SD-RTMS/flight-unit/README.md

# flight-unit


flight unit hardware and software
