SD-RTMS/flight-unit/(threads)

Thread 4 (2020-11-05):

Re-program Issue

danielstumpp, 2020-11-05:
For some reason once the board is programmed once it needs to be manually reprogrammed before flashing new code to the board.

My best guess is that this is caused by dynamic memory allocation somewhere.

This isn't preventing development, but it is pretty annoying.

danielstumpp, 2020-11-05:
Update: it is definitely an issue in either fram.cpp, memory_if.cpp, or downlink_messages.cpp. I think it is in downlink_messages

danielstumpp, 2020-11-05:
looks like I have a fix for this. I will submit a PR and outline it there

Closed 2020-11-06.

Thread 5 (2020-11-05):

FRAM Lib Dependencies

danielstumpp, 2020-11-05:
There is an issue with FRAM SPI library dependencies which is causing CI builds to fail. It's on my to-do list but not high up there
