SD-RTMS/flight-unit/hardware/flight_unit.brd

## EAGLE design hardware/flight_unit.brd (2020-09-25)

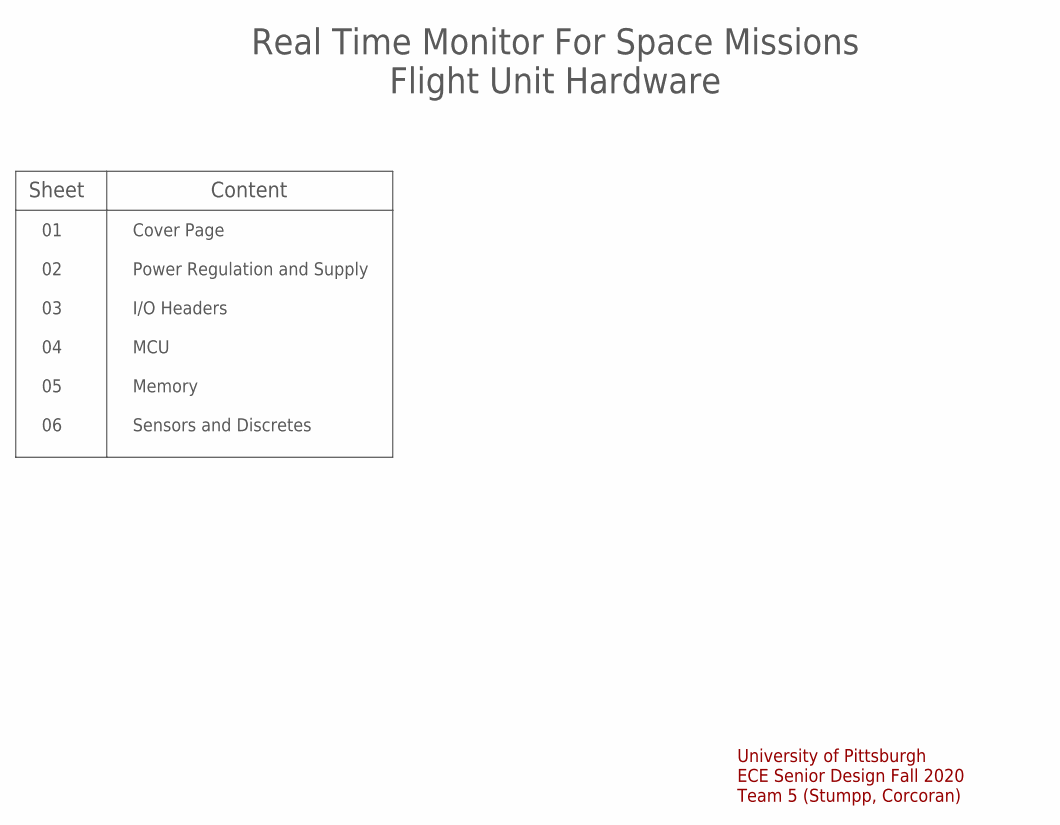
[picture p7: schematic flight_unit.sch, sheet 1]

Notes on the sheet:
University of Pittsburgh ECE Senior Design Fall 2020 Team 5 (Stumpp, Corcoran)
Real Time Monitor For Space Missions Flight Unit Hardware
Content
01 02 03 04 05 06
Cover Page Power Regulation and Supply I/O Headers MCU Memory Sensors and Discretes
Sheet

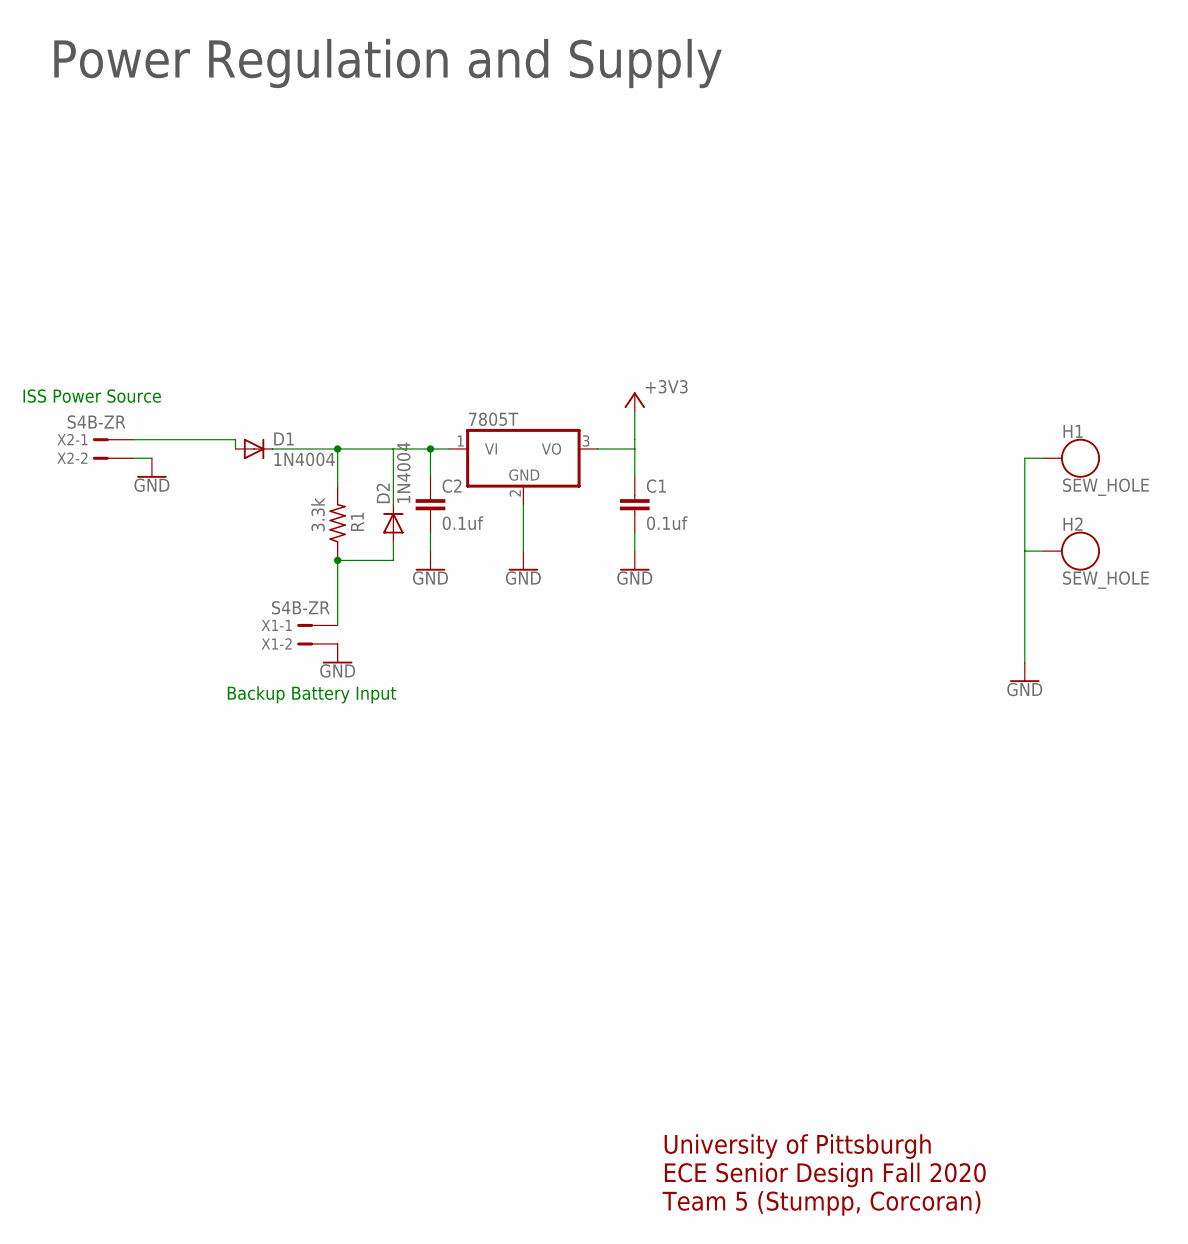
[picture p8: schematic flight_unit.sch, sheet 2]

Parts:
C1, C2: 0.1uf; C2.5-3
D1, D2: 1N4004; DO41-10
H1, H2: SEW_HOLE; SIMPLE_HOLE
IC2: 7805T; TO220H
R1: 3.3k; 0207/10
X1, X2: S4B-ZR

Connections:
+3V3: C1.1, IC2.3 (VO); also elsewhere on the board
GND: C1.2, C2.2, H1.P$1, H2.P$1, IC2.2 (GND), X1.2, X2.2; also elsewhere on the board
unnamed: D2.A, R1.1, X1.1
unnamed: C2.1, D1.C, D2.C, IC2.1 (VI), R1.2
unnamed: D1.A, X2.1

Notes on the sheet:
University of Pittsburgh ECE Senior Design Fall 2020 Team 5 (Stumpp, Corcoran)
Power Regulation and Supply
ISS Power Source
Backup Battery Input

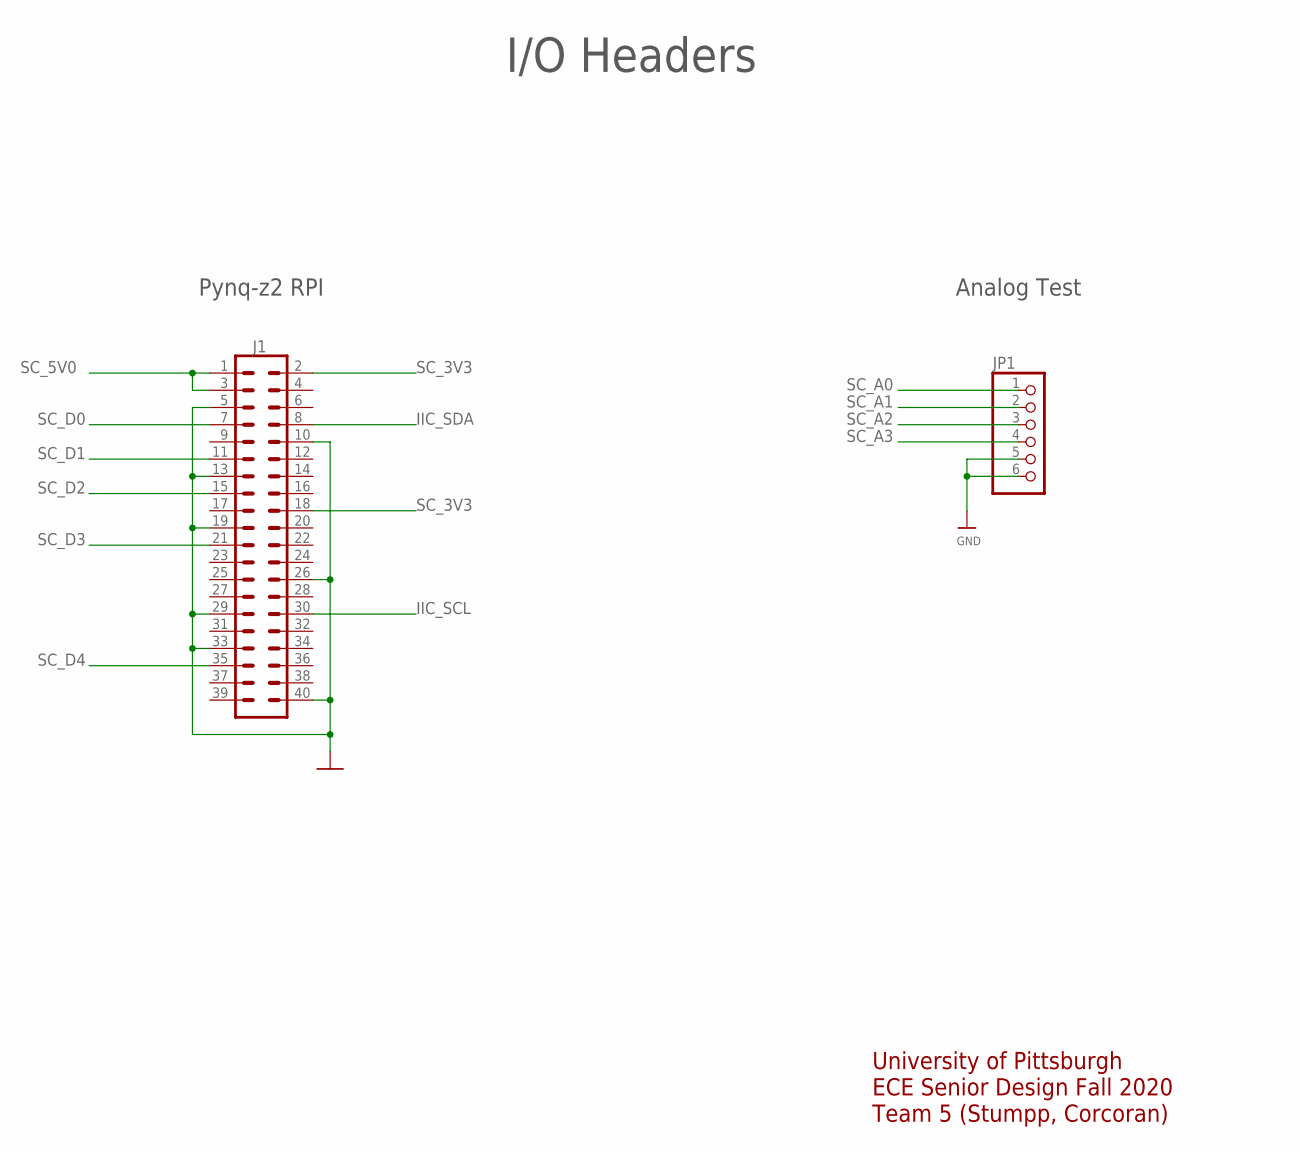
[picture p9: schematic flight_unit.sch, sheet 3]

Parts:
J1: CONN_20X2SHROUDED; 2X20_SHROUDED
JP1: PINHD-1X6B; 1X06-BIG

Connections:
GND: J1.5, J1.10, J1.13, J1.19, J1.26, J1.29, J1.33, J1.40, JP1.5, JP1.6; also elsewhere on the board
IIC_SCL: J1.30; also elsewhere on the board
IIC_SDA: J1.8; also elsewhere on the board
SC_3V3: J1.2, J1.18; also elsewhere on the board
SC_5V0: J1.1, J1.3; also elsewhere on the board
SC_A0: JP1.1; also elsewhere on the board
SC_A1: JP1.2; also elsewhere on the board
SC_A2: JP1.3; also elsewhere on the board
SC_A3: JP1.4; also elsewhere on the board
SC_D0: J1.7; also elsewhere on the board
SC_D1: J1.11; also elsewhere on the board
SC_D2: J1.15; also elsewhere on the board
SC_D3: J1.21; also elsewhere on the board
SC_D4: J1.35; also elsewhere on the board

Notes on the sheet:
University of Pittsburgh ECE Senior Design Fall 2020 Team 5 (Stumpp, Corcoran)
I/O Headers
Analog Test
Pynq-z2 RPI

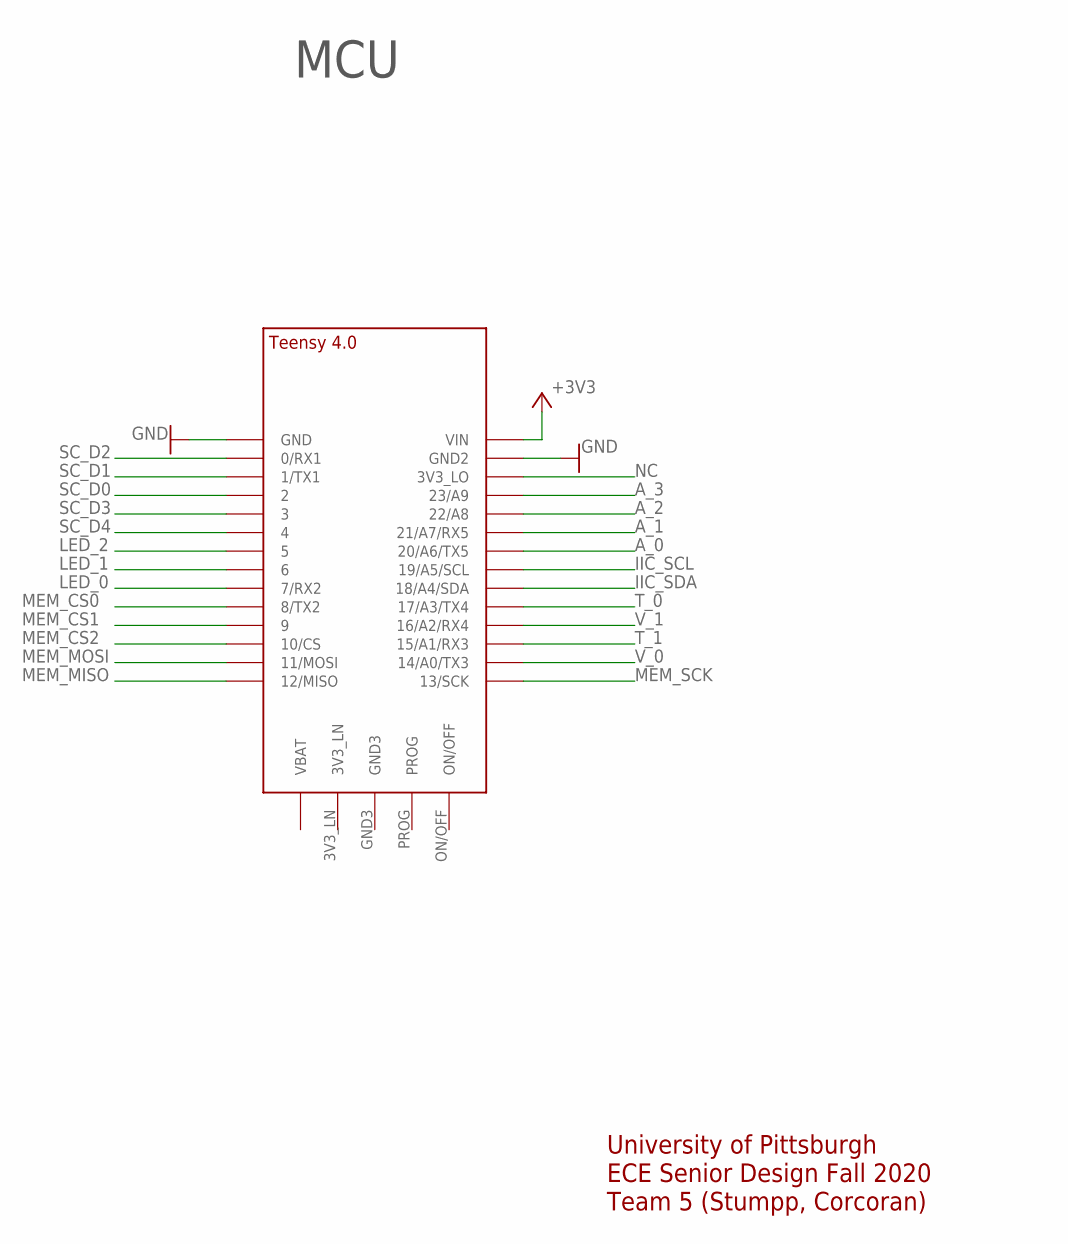
[picture p10: schematic flight_unit.sch, sheet 4]

Parts:
U$1: TEENSY_4.0

Connections:
+3V3: U$1.VIN; also elsewhere on the board
A_0: U$1.20/A6 (20/A6/TX5); also elsewhere on the board
A_1: U$1.21/A7 (21/A7/RX5); also elsewhere on the board
A_2: U$1.22/A8; also elsewhere on the board
A_3: U$1.23/A9; also elsewhere on the board
GND: U$1.GND, U$1.GND2; also elsewhere on the board
IIC_SCL: U$1.19/A5/SCL; also elsewhere on the board
IIC_SDA: U$1.18/A4/SDA; also elsewhere on the board
LED_0: U$1.7 (7/RX2); also elsewhere on the board
LED_1: U$1.6; also elsewhere on the board
LED_2: U$1.5; also elsewhere on the board
MEM_CS0: U$1.8 (8/TX2); also elsewhere on the board
MEM_CS1: U$1.9/CS (9); also elsewhere on the board
MEM_CS2: U$1.10/CS; also elsewhere on the board
MEM_MISO: U$1.12/MISO; also elsewhere on the board
MEM_MOSI: U$1.11/MOSI; also elsewhere on the board
MEM_SCK: U$1.13/SCK; also elsewhere on the board
NC: U$1.3V3_LO
SC_D0: U$1.2; also elsewhere on the board
SC_D1: U$1.1/TX (1/TX1); also elsewhere on the board
SC_D2: U$1.0/RX (0/RX1); also elsewhere on the board
SC_D3: U$1.3/CANTX (3); also elsewhere on the board
SC_D4: U$1.4/CANRX (4); also elsewhere on the board
T_0: U$1.17/A3 (17/A3/TX4); also elsewhere on the board
T_1: U$1.15/A1 (15/A1/RX3); also elsewhere on the board
V_0: U$1.14/A0 (14/A0/TX3); also elsewhere on the board
V_1: U$1.16/A2 (16/A2/RX4); also elsewhere on the board

Notes on the sheet:
University of Pittsburgh ECE Senior Design Fall 2020 Team 5 (Stumpp, Corcoran)
MCU

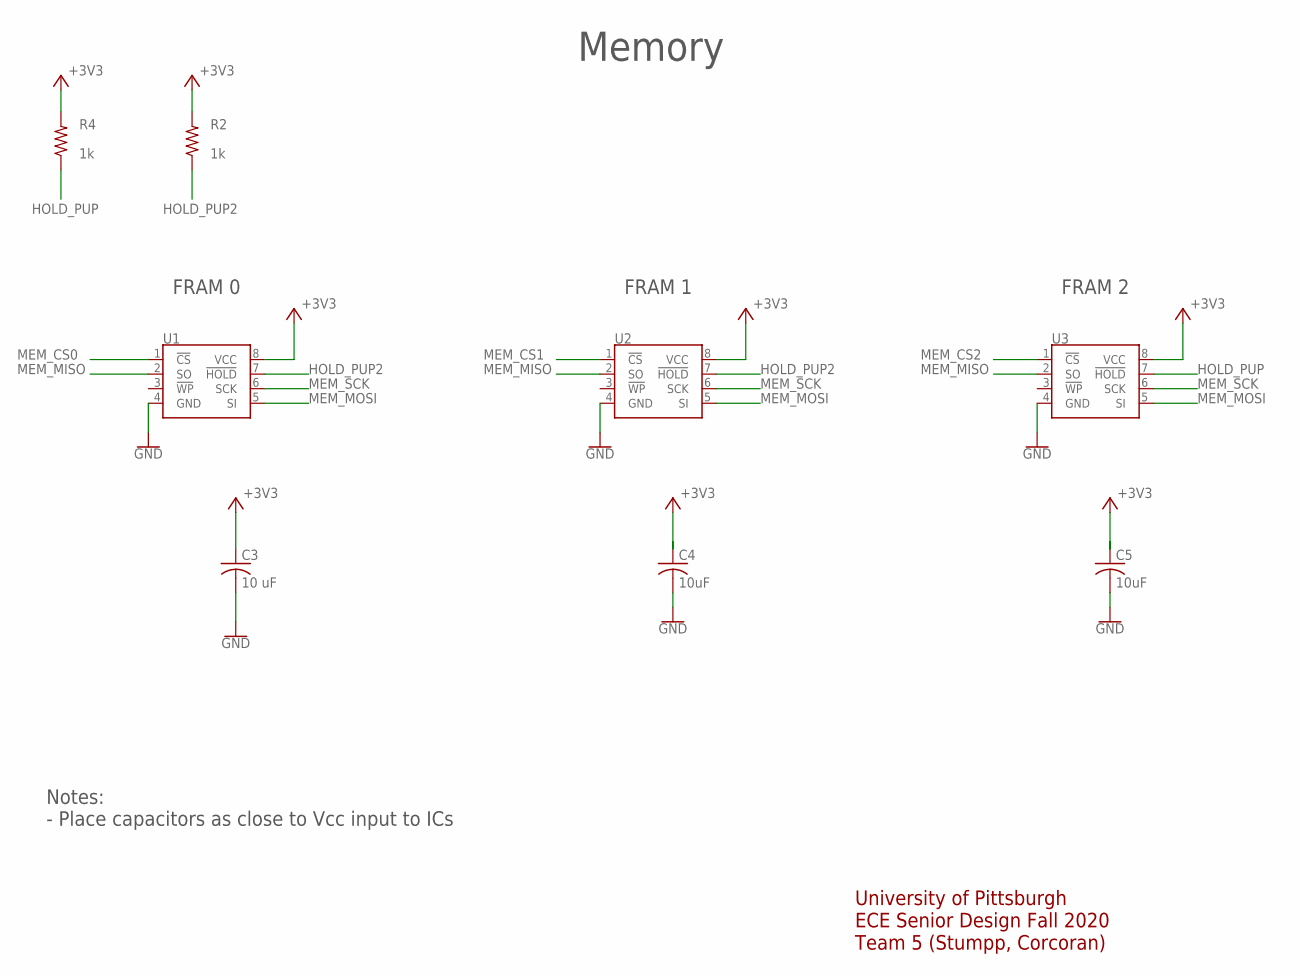
[picture p11: schematic flight_unit.sch, sheet 5]

Parts:
C3: 10 uF; C0805K
C4, C5: 10uF; C0805K
R2, R4: 1k; R1210
U1, U2, U3: 4MB Flash; SO08

Connections:
+3V3: C3.1, C4.1, C5.1, R2.2, R4.2, U1.8 (VCC), U2.8 (VCC), U3.8 (VCC); also elsewhere on the board
GND: C3.2, C4.2, C5.2, U1.4 (GND), U2.4 (GND), U3.4 (GND); also elsewhere on the board
HOLD_PUP: R4.1, U3.7 (!HOLD)
HOLD_PUP2: R2.1, U1.7 (!HOLD), U2.7 (!HOLD)
MEM_CS0: U1.1 (!CS); also elsewhere on the board
MEM_CS1: U2.1 (!CS); also elsewhere on the board
MEM_CS2: U3.1 (!CS); also elsewhere on the board
MEM_MISO: U1.2 (SO), U2.2 (SO), U3.2 (SO); also elsewhere on the board
MEM_MOSI: U1.5 (SI), U2.5 (SI), U3.5 (SI); also elsewhere on the board
MEM_SCK: U1.6 (SCK), U2.6 (SCK), U3.6 (SCK); also elsewhere on the board

Notes on the sheet:
University of Pittsburgh ECE Senior Design Fall 2020 Team 5 (Stumpp, Corcoran)
Memory
FRAM 0
FRAM 1
FRAM 2
Notes: - Place capacitors as close to Vcc input to ICs

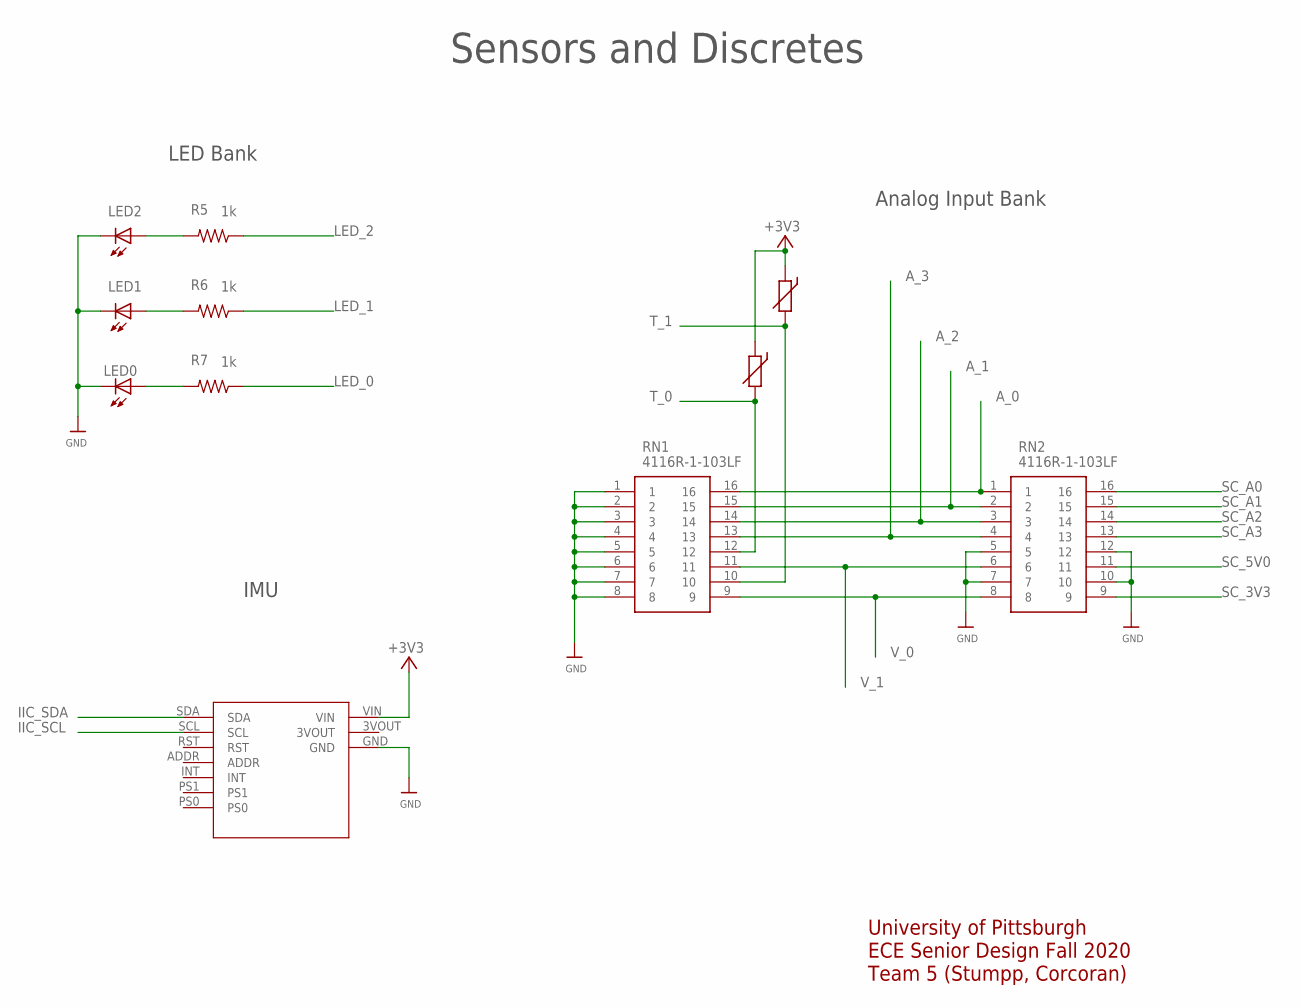
[picture p12: schematic flight_unit.sch, sheet 6]

Parts:
LED0, LED1, LED2: LED3MM
R5, R6, R7: 1k; R1210
R8: THERMISTOR-2,5; RS-2,5
RN1, RN2: 4116R-1-103LF; DIP787W49P254L2197H469Q16N
T1: THERMISTOR-2,5; RS-2,5
U$3: IMU_BREAKOUT; BNO055_BREAKOUT

Connections:
+3V3: R8.1, T1.1, U$3.VIN; also elsewhere on the board
A_0: RN1.16, RN2.1; also elsewhere on the board
A_1: RN1.15, RN2.2; also elsewhere on the board
A_2: RN1.14, RN2.3; also elsewhere on the board
A_3: RN1.13, RN2.4; also elsewhere on the board
GND: LED0.K (C), LED1.K (C), LED2.K (C), RN1.1, RN1.2, RN1.3, RN1.4, RN1.5, RN1.6, RN1.7, RN1.8, RN2.5, RN2.7, RN2.10, RN2.12, U$3.GND; also elsewhere on the board
IIC_SCL: U$3.SCL; also elsewhere on the board
IIC_SDA: U$3.SDA; also elsewhere on the board
LED_0: R7.1; also elsewhere on the board
LED_1: R6.1; also elsewhere on the board
LED_2: R5.1; also elsewhere on the board
unnamed: LED0.A, R7.2
unnamed: LED1.A, R6.2
unnamed: LED2.A, R5.2
SC_3V3: RN2.9; also elsewhere on the board
SC_5V0: RN2.11; also elsewhere on the board
SC_A0: RN2.16; also elsewhere on the board
SC_A1: RN2.15; also elsewhere on the board
SC_A2: RN2.14; also elsewhere on the board
SC_A3: RN2.13; also elsewhere on the board
T_0: R8.2, RN1.12; also elsewhere on the board
T_1: RN1.10, T1.2; also elsewhere on the board
V_0: RN1.9, RN2.8; also elsewhere on the board
V_1: RN1.11, RN2.6; also elsewhere on the board

Notes on the sheet:
University of Pittsburgh ECE Senior Design Fall 2020 Team 5 (Stumpp, Corcoran)
Sensors and Discretes
IMU
LED Bank
Analog Input Bank

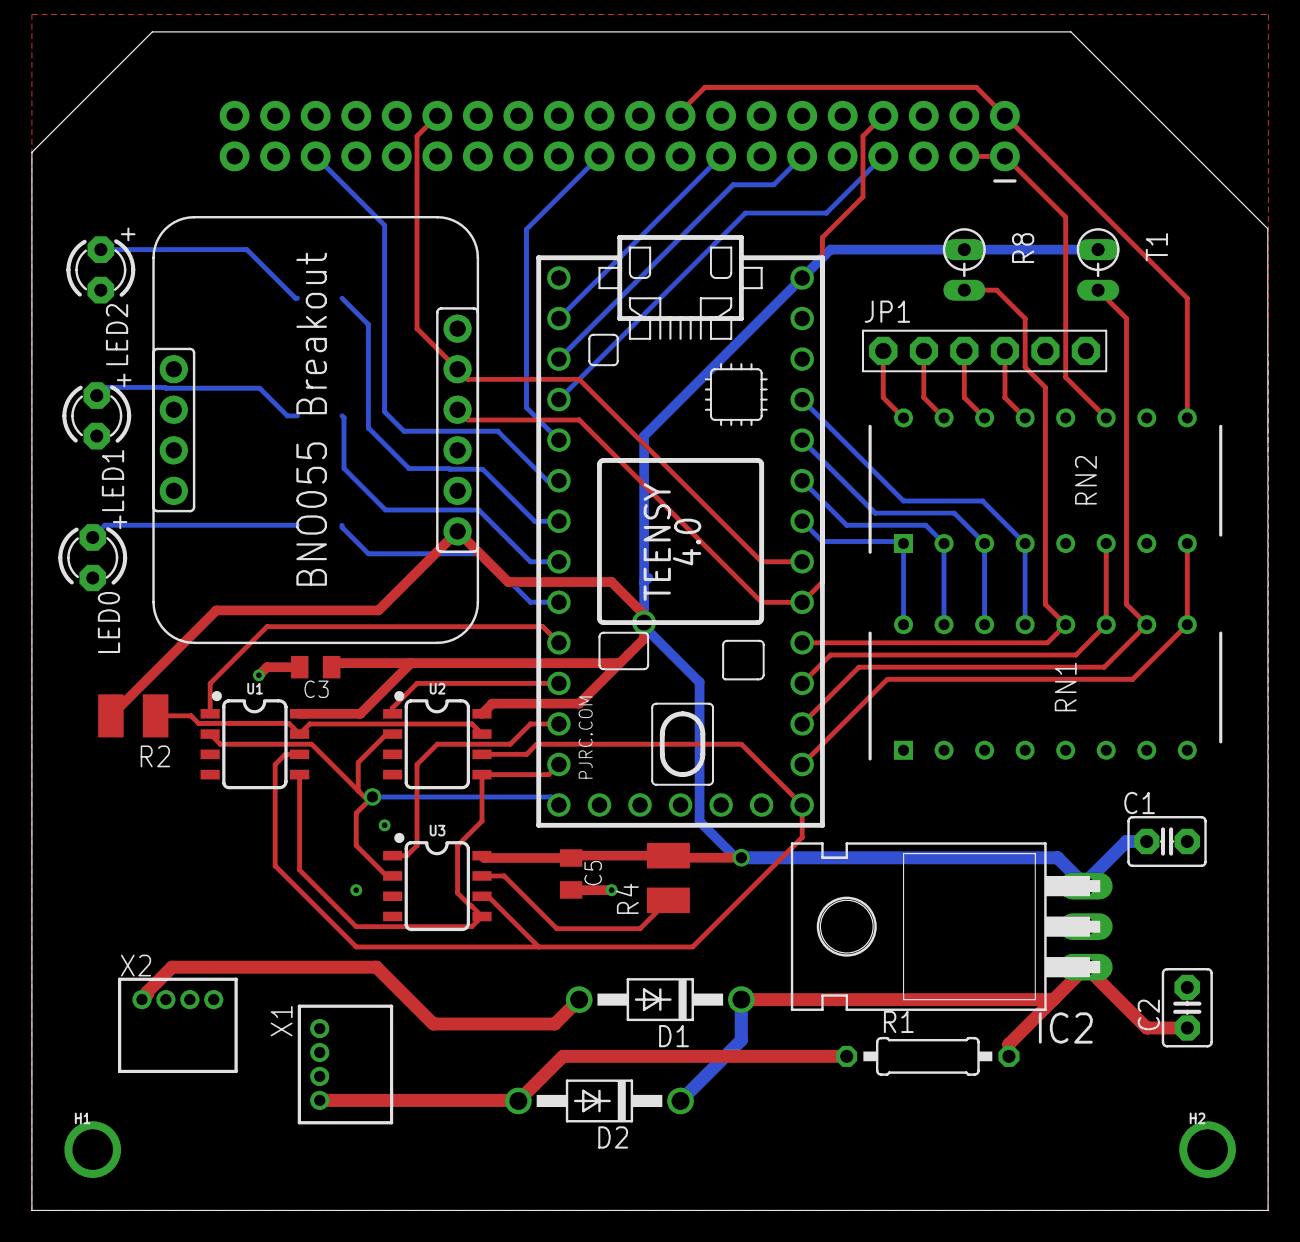
[picture p13: board flight_unit.brd from above]

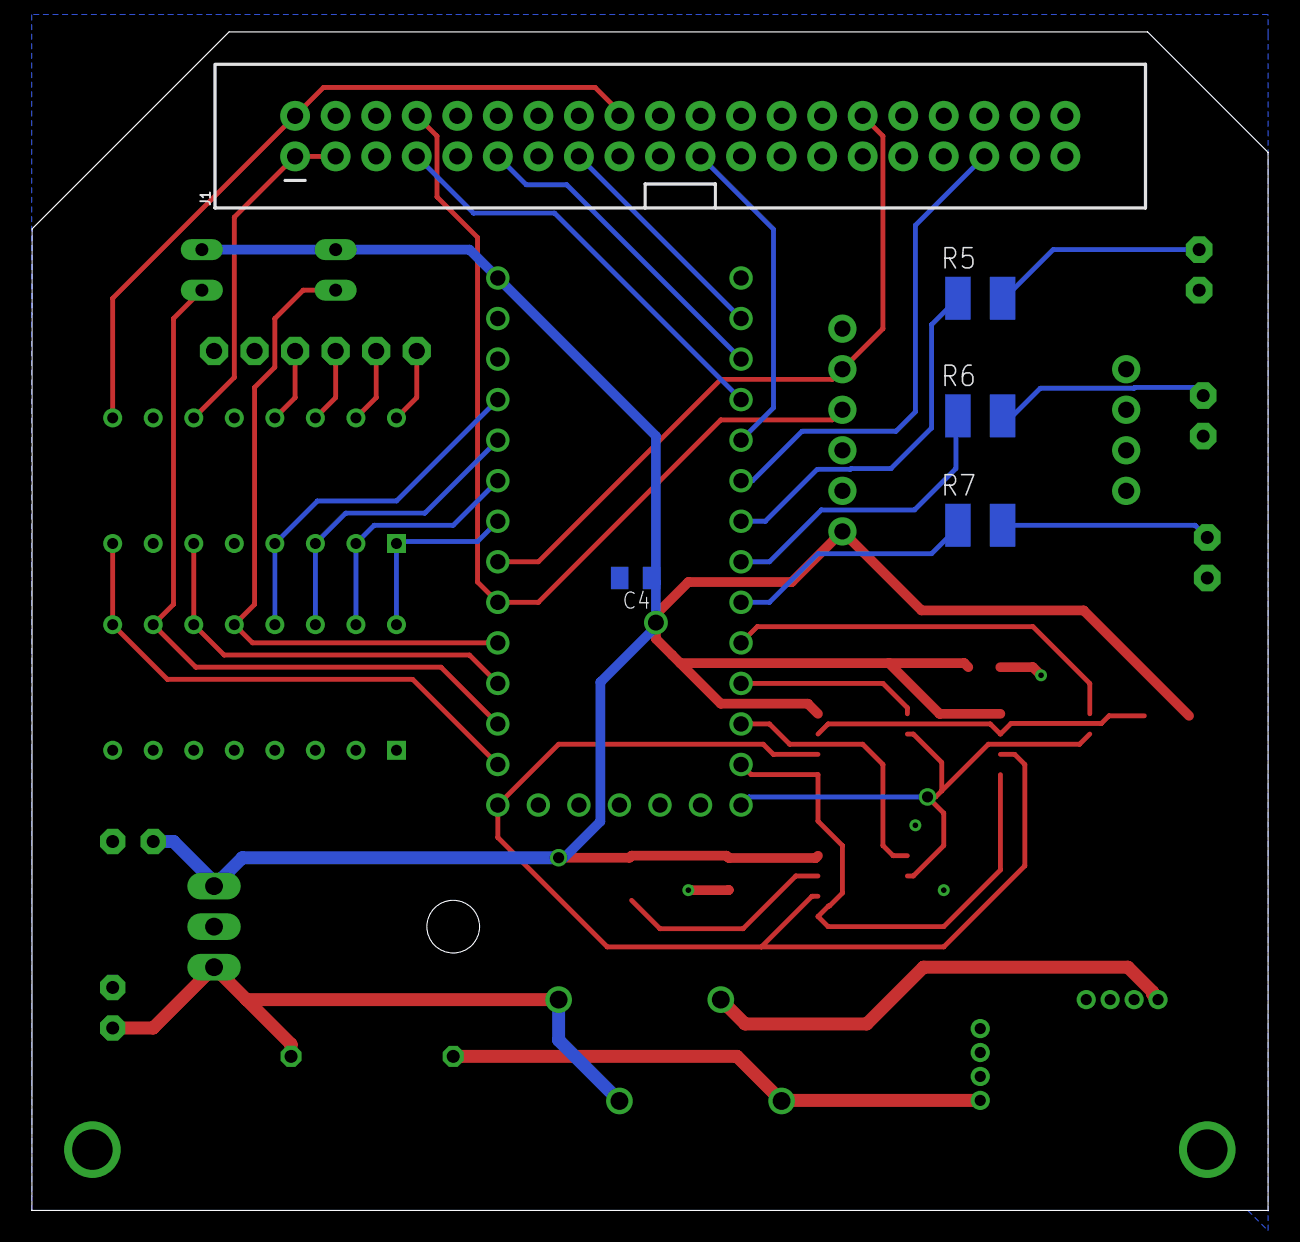
[picture p14: board flight_unit.brd from below]

Board: 2 copper layers, 77.5 x 73.8 mm, 32 parts (5 on the bottom side), 40 nets.
