SD-RTMS/flight-unit/(commit log)

2020-09-16 updated file structure
    [RTMS Voltage Regulation Circuit.sch]
2020-09-16 created master schematic
    [flight_unit.sch]
2020-09-17 finished teplate and added pynq-z2 connector
    [flight_unit.sch]
2020-09-17 added fram and MCU
    [flight_unit.sch]
2020-09-18 Added DIP resistor packages for analog bank
    [flight_unit.sch]
2020-09-18 Created and added IMU library part
    [flight_unit.brd, flight_unit.sch]
2020-09-18 updated i/o headers
    [flight_unit.brd, flight_unit.sch]
2020-09-18 created pin map header
2020-09-18 added digital_io class framework
2020-09-20 added start of fram framework
    [flight_unit.brd, flight_unit.sch]
2020-09-21 fix back annotation error
    [flight_unit.brd]
2020-09-21 fixed back annotation error **don't copy and replace the schematic**
    [flight_unit.brd, flight_unit.sch]
2020-09-21 added imu repo as submodule
2020-09-21 accidently deleted this
    [flight_unit.brd, flight_unit.sch]
2020-09-22 Added decoupling caps to memory schematic
    [flight_unit.brd, flight_unit.sch]
2020-09-22 updates to schematic and preliminary board work
    [flight_unit.brd, flight_unit.sch]
2020-09-22 working on board layout
    [flight_unit.brd, flight_unit.sch]
2020-09-24 working on routing...
    [flight_unit.brd, flight_unit.sch]
2020-09-24 few more tweaks.
    [flight_unit.brd, flight_unit.sch]
2020-09-25 finalized preliminary routing
    [flight_unit.brd, flight_unit.sch]
2020-10-21 Fixed case sensitive includes for linux build
    [imu.cpp, main.cpp]
2020-10-23 Thermistors
    Converts analog signal to thermistor temp readings
2020-11-03 swaped proto structs in for existing data structs, added debug preprocessor statements
    [analog_io.cpp, analog_io.hpp, digital_io.cpp, digital_io.hpp, fram.cpp, fram.hpp, imu.cpp, imu.hpp]
2020-11-05 added initial IMU interface as class, fixing previous implementation
    [analog_io.cpp, analog_io.hpp, digital_io.cpp, digital_io.hpp, fram.cpp, fram.hpp, imu.cpp, imu.hpp]
2020-11-06 bug fixes, fram working
    [analog_io.cpp, digital_io.cpp, donwlink_message.hpp, downlink_message.cpp, fram.cpp, imu.cpp, main.cpp, memory_if.cpp]
2020-11-06 remove old fix, problem was resolved
    [main.cpp]
2020-11-07 added watchdog timer to reset on hangs
    [Watchdog_t4.h, main.cpp]
2020-11-09 Added Error indicators for initliazing sensors/IOs
    LEDs on board will output binary to indicate which components are not initalizing properly. Wont let system continue unless all are initialized
    [digital_io.cpp, digital_io.hpp, main.cpp]
2020-11-09 Linear and Angular Acceleration Edits
    Added linear acceleration. Changed magnitude to "mag" for magnetization vectors. Added fourth quat_d. Also added linear accleration to proto files
2020-11-09 updated has for power supply
2020-11-09 changes to switch to new proto, test working
